adarsh-911/Frostbite-prevention-sock/README.md

# Frostbite prevention sock

Status : In progress
## About
Design of a compact (5cm x 4cm) PCB to monitor and control analog temperature sensors and a heating element with Bluetooth capability

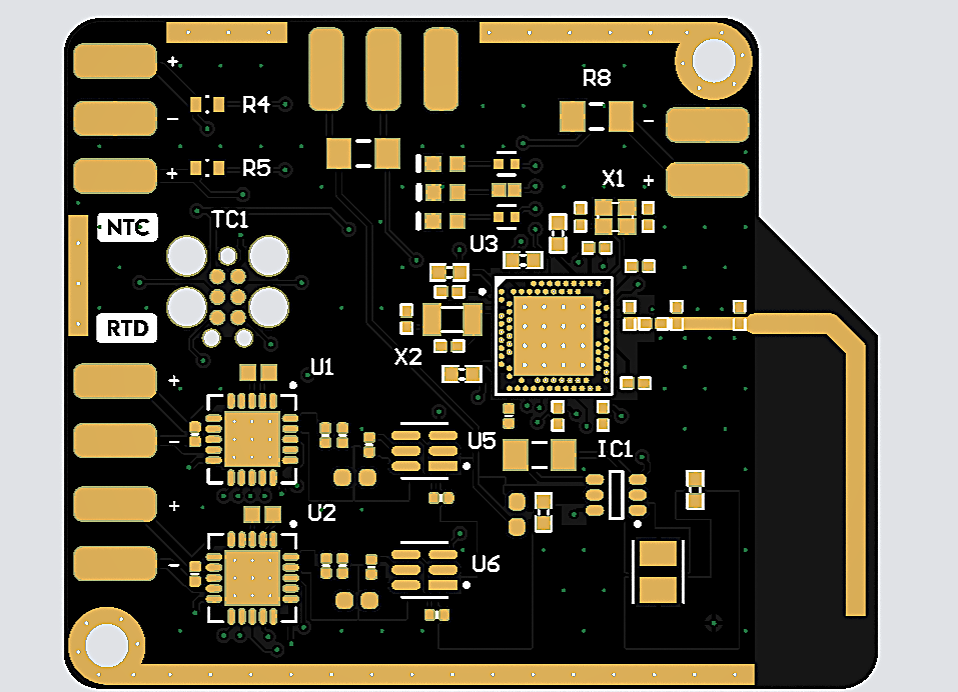
[picture p1: figs/pcb_top.png]
Top

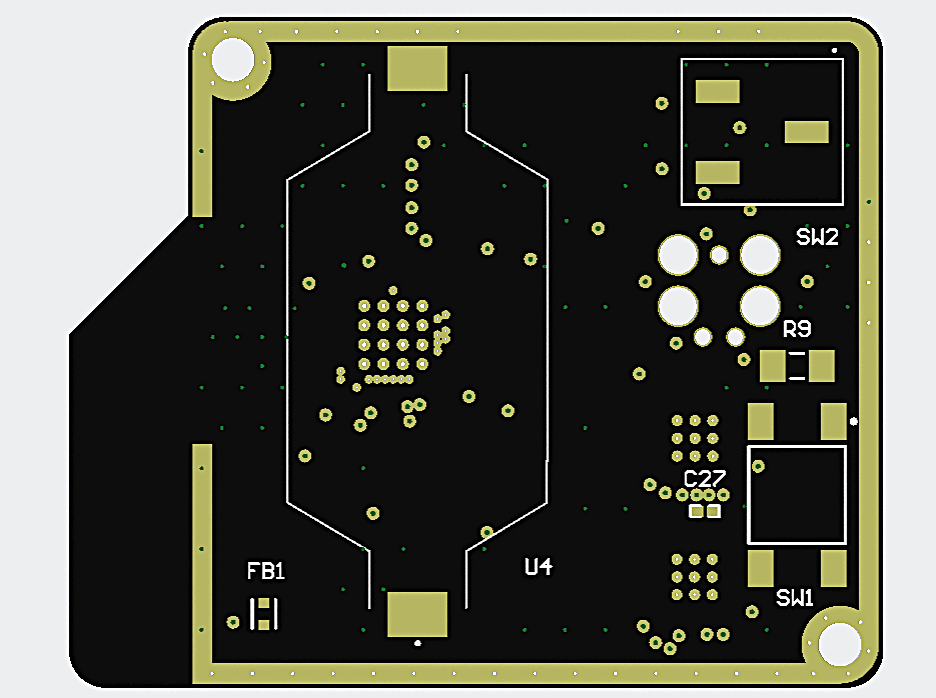
[picture p2: figs/pcb_bottom.png]
Bottom
