adarsh-911/Frostbite-prevention-sock/prototype/figs/ntc/ice1.png

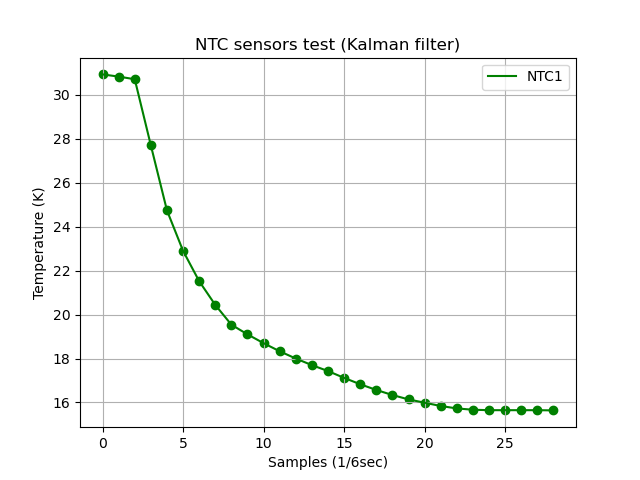
prototype/figs/ntc/ice1.png
