adarsh-911/Frostbite-prevention-sock/prototype/figs/ntc/skin1.png

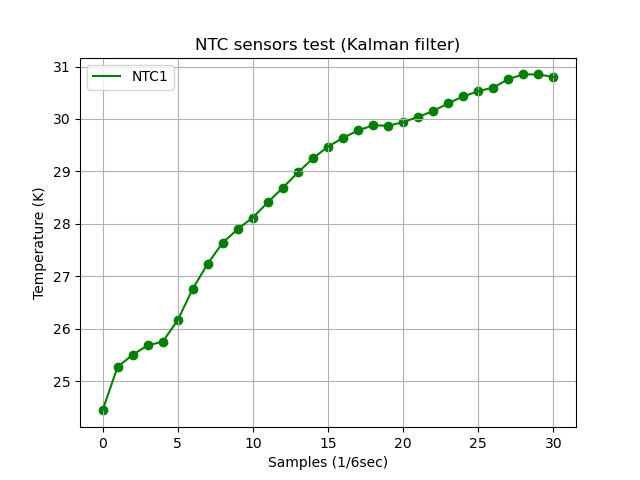
prototype/figs/ntc/skin1.png
