adarsh-911/Frostbite-prevention-sock/prototype/figs/pt100/skin1.png

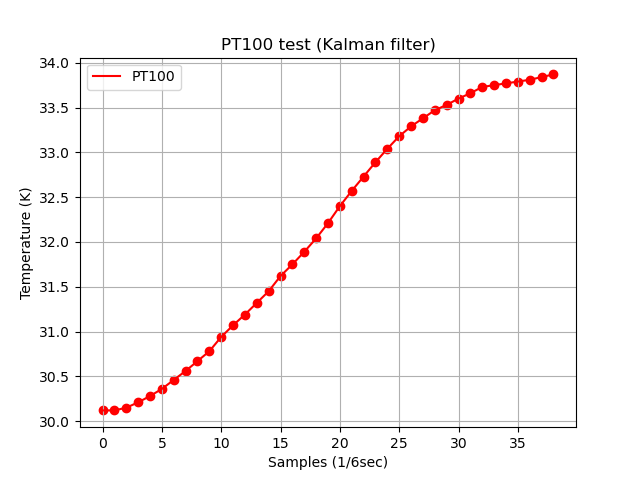
prototype/figs/pt100/skin1.png
