adarsh-911/Frostbite-prevention-sock/(list of files, drawings)

Other design files:
PCB-Altium files/Sch_sheet1.SchDoc
PCB-Altium files/Smart_sock.PrjPcb
